tomg1103/Custom-Audio-Cart-Project/Table hole grommet v2.stl

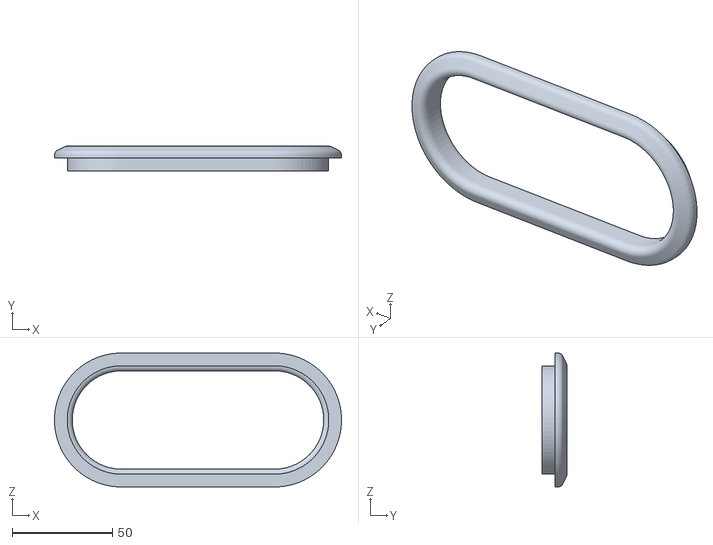
[picture p1: CAD file, 2022-10-06]
Table hole grommet v2.stl
142.8 x 12.3 x 66.7
