tomg1103/Custom-Audio-Cart-Project/Table hole grommet v1.stl

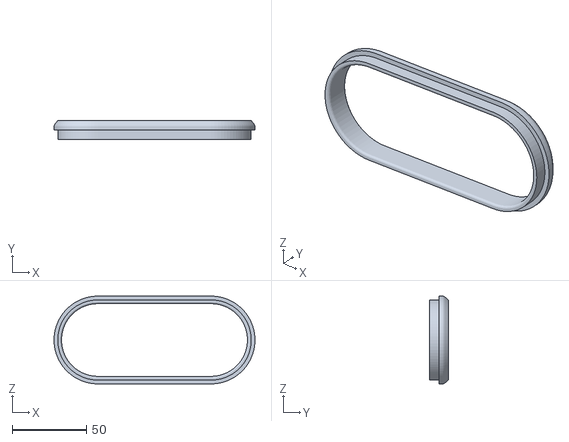
[picture p2: CAD file, 2022-10-06, an earlier design]
Table hole grommet v1.stl
135.3 x 12.7 x 59.1
