tomg1103/Custom-Audio-Cart-Project/(commit log)

2022-09-30 Added through Final wiring and Setup
    need to add final pictures and proofread
2022-10-06 V1 and V2 of the 3d Printed Grommet STLs uploaded
    [Table hole grommet v1.stl, Table hole grommet v2.stl]
